Hoogspanningsnet/HSNetmeter/Software Server/spinner.gif

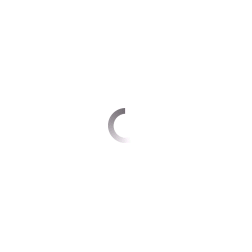
Software Server/spinner.gif
