Hoogspanningsnet/HSNetmeter/Hardware/Packinglist.xlsx

Onderdelen voor de HSNetmeter V1.1
 | C1,C2 | C3 | R1, R4
 | 100nF | 10uF | 330Ohm
 | F1 | FB1 | IC2
 | Polyfuse | Ferrietkraal | 74HC132D
 | R2,R3 | LED1 | OK1A/B
 | 10kOhm | LED Groen | LTV817
 | C1,C2 | C3 | R1, R4
 | 100nF | 10uF | 330Ohm
 | F1 | FB1 | IC2
 | Polyfuse | Ferrietkraal | 74HC132D
 | R2,R3 | LED1 | OK1A/B
 | 10kOhm | LED Groen | LTV817
