Hoogspanningsnet/HSNetmeter/Hardware/HSNetMeter/HSNetmeter-simple-v1.1.brd

## EAGLE design Hardware/HSNetmeter-simple-v1.1.brd (2018-03-12, last stored version)

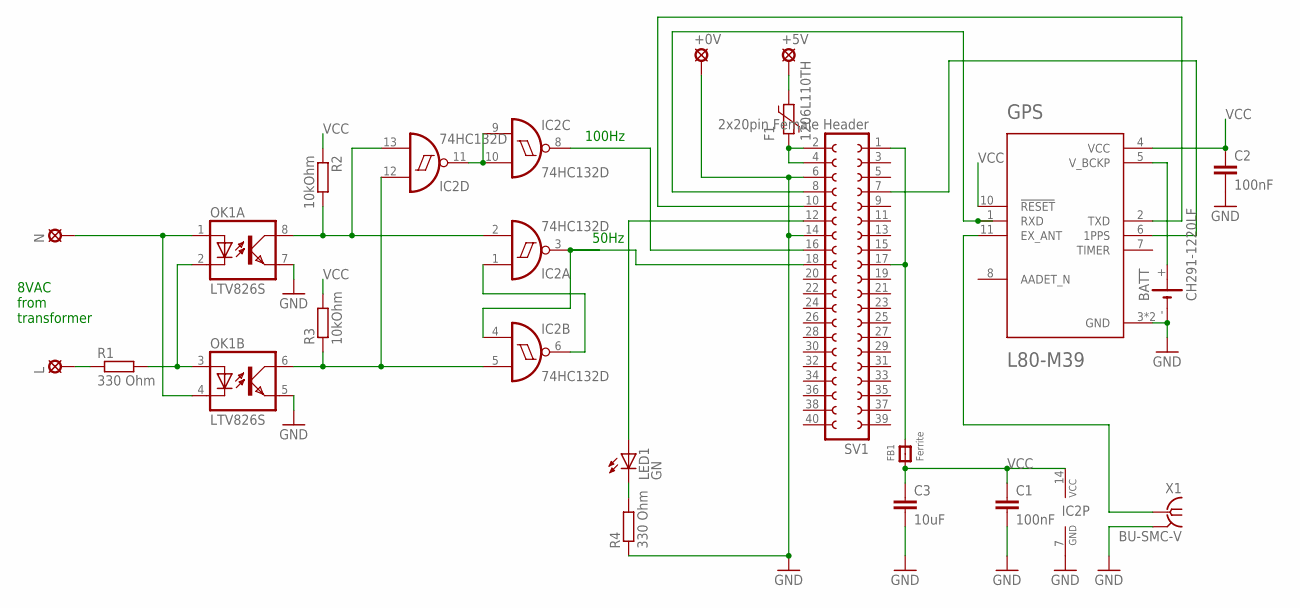
[picture p2: schematic HSNetmeter-simple-v1.1.sch]

Parts:
+0V, +5V: LSP11
BATT: CH291-1220LF
C1, C2: 100nF; C0805
C3: 10uF; C1206
F1: 1206L110TH; 1206L
FB1: Ferrite; 0805
GPS: L80-M39; QUECTEL_L80-M39
IC2: 74HC132D; SO14
L: LSP11
LED1: GN; LED3MM
N: LSP11
OK1: LTV826S; DIL8-SMD
R1, R4: 330 Ohm; M0805
R2, R3: 10kOhm; M0805
SV1: 2x20pin Female Header; FE20-2
X1: BU-SMC-V

Connections:
+3.3V: FB1.2, SV1.1, SV1.17
GND: +0V.MP, BATT.-, C1.2, C2.2, C3.2, GPS.3 (GND), GPS.12 (GND), IC2.7 (GND), OK1.5 (EMIT), OK1.7 (EMIT), R4.1, SV1.6, SV1.14, X1.2, X1.3 (2), X1.4 (2), X1.5 (2)
unnamed: IC2.8 (O), SV1.16
unnamed: L.MP, R1.1
unnamed: LED1.K (C), R4.2
unnamed: N.MP, OK1.1 (A), OK1.4 (C)
unnamed: F1.2, SV1.2, SV1.4
unnamed: +5V.MP, F1.1
unnamed: LED1.A, SV1.12
unnamed: GPS.6 (1PPS), SV1.7
unnamed: OK1.2 (C), OK1.3 (A), R1.2
unnamed: GPS.1 (RXD), SV1.8
unnamed: GPS.2 (TXD), SV1.10
unnamed: IC2.2 (I1), IC2.13 (I1), OK1.8 (COL), R2.2
unnamed: IC2.5 (I1), IC2.12 (I0), OK1.6 (COL), R3.1
unnamed: IC2.3 (O), IC2.4 (I0), SV1.18
unnamed: IC2.1 (I0), IC2.6 (O)
unnamed: IC2.9 (I0), IC2.10 (I1), IC2.11 (O)
unnamed: GPS.11 (EX_ANT), X1.1
unnamed: BATT.+, GPS.5 (V_BCKP)
VCC: C1.1, C2.1, C3.1, FB1.1, GPS.4 (VCC), GPS.10 (!RESET), IC2.14 (VCC), R2.1, R3.2

Notes on the sheet:
100Hz
50Hz
8VAC from transformer

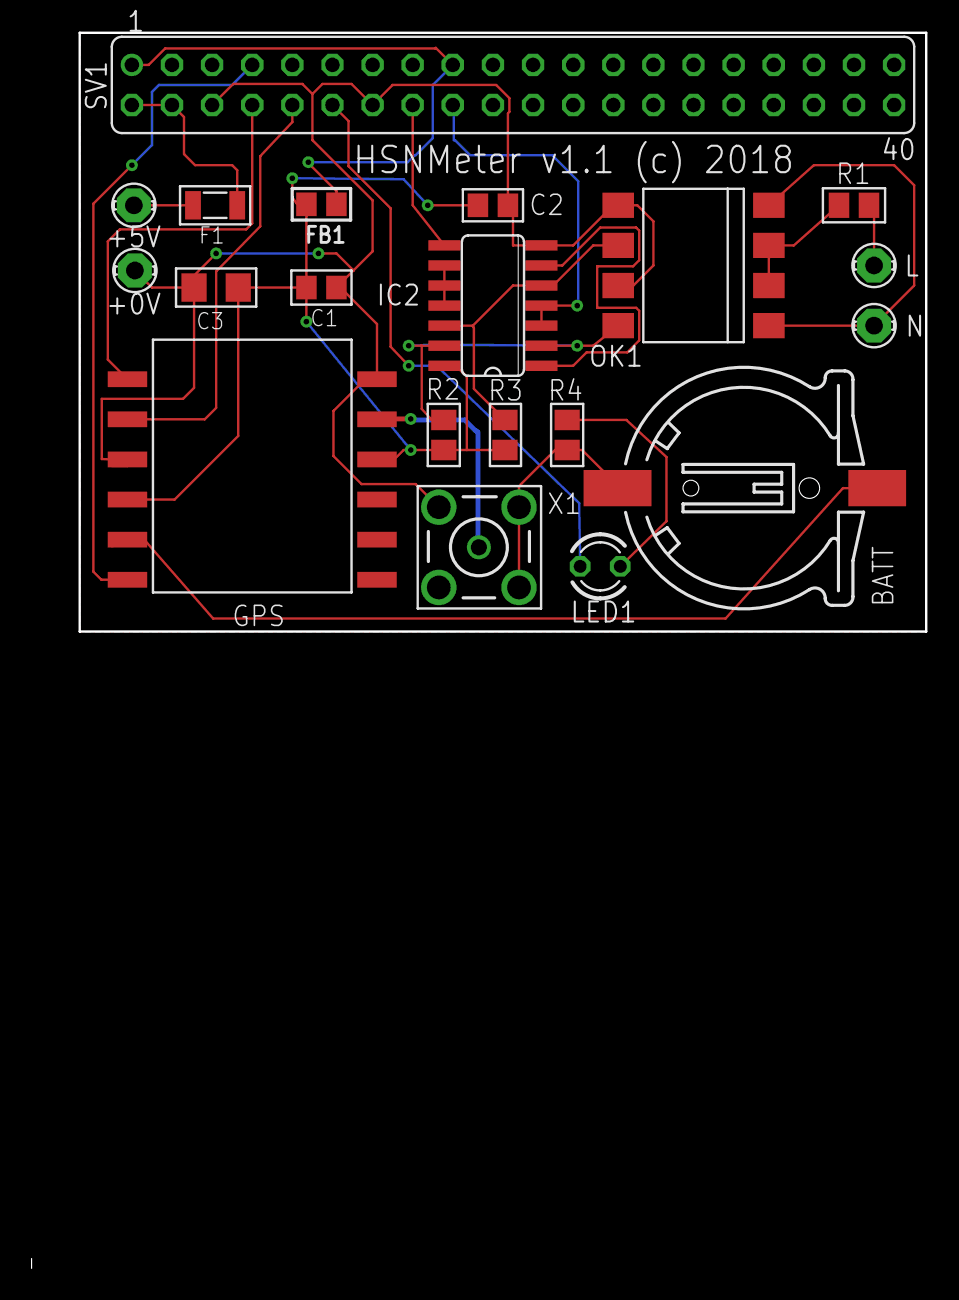
[picture p3: board HSNetmeter-simple-v1.1.brd from above]

Board: 2 copper layers, 53.6 x 37.9 mm, 20 parts (0 on the bottom side), 21 nets.
