Hoogspanningsnet/HSNetmeter/(threads)

Thread 1 (2017-12-12):

Schema wijzigen tbv integratie met RPi

BaDu-HSN, 2017-12-12:
- [x] Voeding vanuit RPi (3,3V bijvoorkeur)
- [x] Andere Schmitt-trigger selecteren voor 3,3V
- [x] Deler laten vervallen
- [x] LED 2 laten vervallen
- [x] 7805, Brug, C1 tm C4 laten vervallen
- [x] R's herberekenen voor 3,3V
- [x] JP1 verkleinen
- [x] Header toevoegen voor Hat-Constructie op RPi
- [x] Kleinere trafo selecteren
- [x] Boorgaten afstemmen op RPi

BaDu-HSN, 2017-12-27:
All done

Closed 2017-12-27.

Thread 2 (2017-12-12):

Frequentie-meet-software maken voor RPi

BaDu-HSN, 2017-12-12:
In Python op basis van pigpio library
http://abyz.me.uk/rpi/pigpio/python.html

- [ ] Iedere 0,5 seconden een frequentie berekenen op basis van de laatste 25 pulsen.
- [ ] Berekende frequentie relateren aan een realtime vanuit NTP (op hele/halve seconden).
- [ ] Berekenen fase verschil met master?
- [ ] Pushen data naar de HSN-webserver

BaDu-HSN, 2018-03-07:
Closed

Closed 2018-03-07.

Thread 3 (2017-12-12):

Ook meten netspanning en met de frequentie mee de server op sturen

HansNien, 2017-12-12:
Zijn er mogelijkheden om ook de netspanning te meten en de server op te slingeren? Lokaal binnen je eigen 400 V heb je daar niet zoveel aan want een zware gebruiker aanslingeren is al genoeg voor een dip, maar als we het op vier geografisch verschillende plekken meten en hij dipt op twee of meer plekken tegelijk, dan is er toch echt wat groters aan de hand en hebben we een mogelijke, vroege indicatie van een serieuzere hickup ergens op het net.

BaDu-HSN, 2017-12-12:
Eigenlijk is dus een detectie van een DIP belangrijk.
Een DIP is wel redelijk eenvoudig te detecteren, maar vereist wel uitbreiding van de schakeling.

HansNien, 2017-12-12:
Een dip is inderdaad waar het om gaat. Nu is het wel zo dat daar eerst een definitie voor moet worden gesteld wat we als een significante dip opvatten en waar de grenswaarde dan zou moeten komen te liggen. (Gepruttel met Spijkerskromme en de categorieën die Tennet hanteert lijken met overkill, er moet dan gewoon een slim gekozen dieper-dan en langer-dan worden gesteld.)

Als het toegevoegde componenten op de schakeling vereist en deze daardoor iets duurder en complexer wordt, voorzie ik nog niet meteen problemen, althans, ik zou ze zelf niet hebben omdat het ook wel degelijk waarde toevoegt. Met de netfrequentie en de spanning(sdippen) kunnen we in principe alles dat van belang is volgen, zowel het grootschalig afvallen van load of generatie door calamiteiten, maar ook kortdurende irritaties zoals een schakelfout of sluiting. Helemaal mooi is het als de een voorafgaat aan de ander, dan weten we direct dat er ergens in het ENTSO-E net een TSO heel zenuwachtig wordt.

BaDu-HSN, 2017-12-12:
Gelukkig is er een norm voor, zie de spanning kwaliteit metingen van tennet
Volgens mij staat het ook in de netcode

Thread 4 (2017-12-12):

Notificatiefunctie per SMS of soortgelijk bij overschrijden thresholds

HansNien, 2017-12-12:
Slechts een idee. Mogelijkheid van een functie met alarm erop die een SMS of soortgelijk kan versturen, zodat je telefoon automagisch begint te gillen als de netfrequentie bijvoorbeeld langer dan een halve minuut onder 49,9 Hz zakt (of over 50,1 heen vliegt) en/of als er op bijvoorbeeld twee of meer locaties in de afgelopen minuut simultaan een spanningsdip is geconstateerd.

BaDu-HSN, 2017-12-12:
Er zijn een aantal mogelijkheden:
- SMS (betrekkelijk eenvoudig)
- Twitter (eenvoudig)
- Whatsapp (is complex)
- Mail (simpel)
- Een eigen app die echt begint te gillen (veel werk)

BaDu-HSN, 2018-03-07:
Not for now

Closed 2018-03-07.

Thread 5 (2017-12-27):

Ledje(s) toevoegen om de status weer te geven

BaDu-HSN, 2017-12-27:
LED1 GN: Communicatie met server is OK (knippert bij verzending en OK ontvangen)
LED2 GL: Communicatie met server setup is nodig.

BaDu-HSN, 2018-03-07:
Done (alleen een groene LED)

Closed 2018-03-07.

Thread 6 (2017-12-30):

Wrap around maken voor de teller

BaDu-HSN, 2017-12-30:
De us-teller loopt iedere 72 minuten rond en geeft dan een raar resultaat.

Iets van :
Als nieuwe_timer_stand < vorige_stand dan
  verschil=nieuwe_timer_stand + (max_stand-vorige_stand)
anders
  verschil=nieuwe_timer_stand - vorige_stand

Kolky, 2018-07-09:
Op de webpagina al opgenomen; moet nog in de raspberry worden gefixt.

Thread 7 (2018-03-13):

HW: ADC Opnemen

BaDu-HSN, 2018-03-13:
Waarschijnlijk is een MCP300x goed in te passen.
In principe is 1 kanaal voldoende.

BaDu-HSN, 2018-03-13:
MCP3008 lijkt overkill, maar is goedkoper dan een MCP3001/3002/3004.
Willen we de overige analoge waarden extern aan kunnen sluiten?

Marcello83, 2018-03-13:
Ik zal even uitzoeken welke types er ondersteund worden.

BaDu-HSN, 2018-06-16:
Wont fix in first revision

Closed 2018-06-16.

Thread 8 (2018-03-14):

Elektor-project als voorbeeld

reening, 2018-03-14:
Het bestand was te groot als bijlage op het forum, en GitHub had weinig andere mogelijkheden om deze bestanden te uploaden. Dan maar als issue: [netfrequentie.pdf](https://github.com/Hoogspanningsnet/HSNetmeter/files/1813177/netfrequentie.pdf)

BaDu-HSN, 2018-03-15:
Nais! Dit is een leuke schakeling en wellicht iets om met V2.0 toe te voegen.
Ik zou dan wel het low-pass filter op een andere frequentie leggen zodat we de harmonische vervormingen op de gestandaardiseerde methode (zie netcode) kunnen meten.
Deze schrijft voor dat je t/m de 40e harmonische moet meten (geeft lowpass van 2kHz).

BaDu-HSN, 2018-06-16:
Wont fix in this revision

Closed 2018-06-16.

Thread 9 (2018-06-25):

Geheugen verbruik grafiek

Kolky, 2018-06-25:
Grafiek plugin gebruikt veel geheugen op Chrome en ruimt niet netjes data-punten op. Zo had ik na even vergeten te hebben ineens 1,5 GB aan memory!

BaDu-HSN, 2018-06-25:
Hmmm nooit echt naar gekeken, onder Firefox valt het geheugen gebruik wel mee (veel minder dan de 1,5GB)
In het javascript zit ook een voorziening die oude data punten verwijdert als er nieuwe binnen komen. Dit is een beetje hacky opgelost en geeft soms geen goed resultaat.

Verbetering is echt nodig
