Hoogspanningsnet/HSNetmeter/(commit log)

2018-03-12 Initial commit
    Initial commit
    [HSNetmeter-simple-v1.1.brd, HSNetmeter-simple-v1.1.sch]
2018-03-29 Silent mode toegevoegd
    Zodat de logging de rpi niet te traag maakt.
    [Paklijst Printplaat.xlsx]
2018-04-23 Omgezet naar 50Hz
    Omgezet naar 50Hz
2018-06-21 Small updtaes
    [Paklijst Printplaat.xlsx]
2018-06-21 Clean up
    Clean up
    [Packinglist.xlsx]
2018-07-01 LED brightness and small changes
    - Added option for setting the LED brightness
    - Changed behaviour of mainloop: Check for pigpiod only at startup, do IO config only after pigpiod is there
    - Correct value of frequency is now printed if in verbose mode
    [hsnetmeter.py]
2018-07-01 Revert "LED brightness and small changes"
    This reverts commit f5242062cbc930c0736a85bc865fbcf8e207280f.
    [hsnetmeter.py]
